AdamsAssaadLU/smart-greenhouse-project/sensors - greenhouse project report.pdf

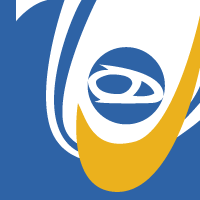
[picture p2: figure]

Lebanese University – Faculty of Engineering

Date: 08/07/2026

Subject: Sensors

Professor: Dr. Mohammad Aoude

## Sensors project report

## (Greenhouse)

PRESENTED BY:

ADAM ASSAAD - 6857

AHMAD MURAD - 6856

HAOULO MSAYLIB - 6909

FARAH MSAYLIB – 6912

Table of Contents

### 1. INTRODUCTION:

Modern agriculture increasingly relies on precision automation to optimize crop yields and conserve resources. This project presents the design and implementation of an automated smart greenhouse system utilizing the Arduino Mega 2560 microcontroller. The system integrates an array of environmental sensors and actuators to regulate microclimate conditions, manage automated irrigation, track water consumption, and provide localized perimeter security.

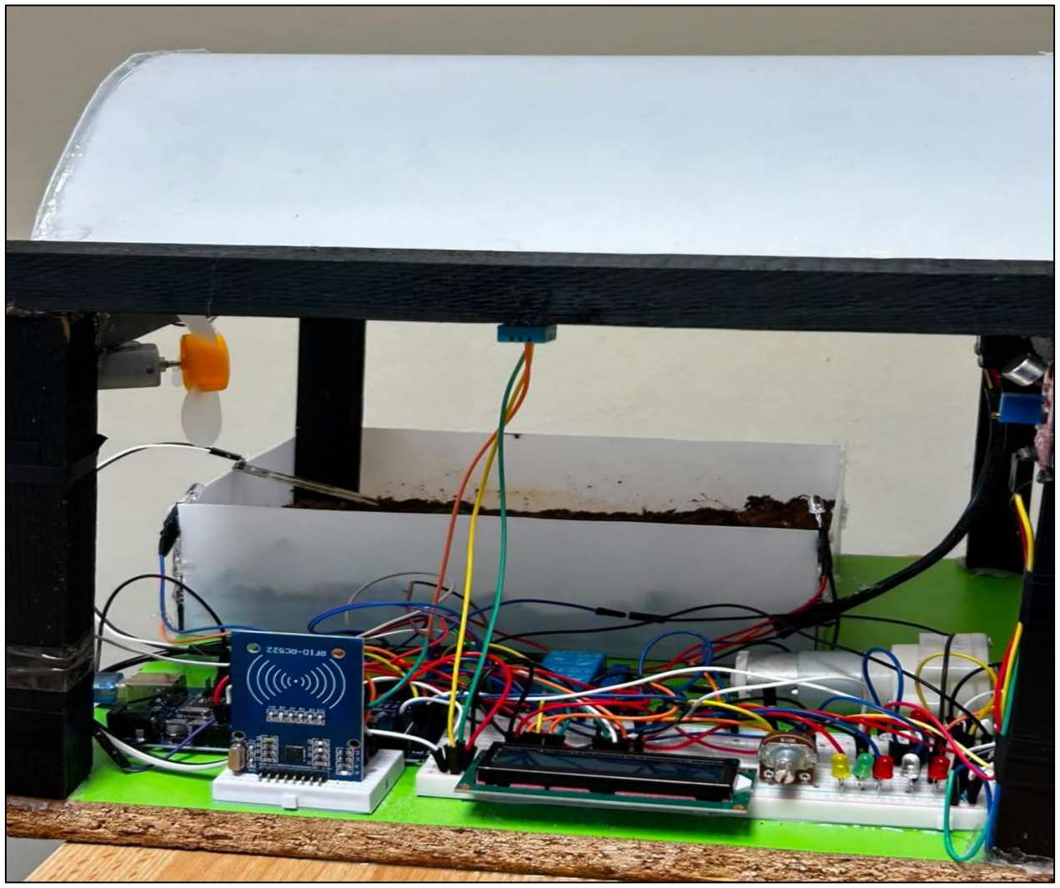
[picture p3: figure]

### 2. PROBLEM STATEMENT:

Traditional greenhouse management relies heavily on manual labor and periodic human observation, which introduces significant risks:

- Delayed Response: Belated detection of thermal stress or soil dehydration can severely hinder plant growth.
- Resource Inefficiency: Manual watering often results in over-irrigation, wasting water and leaching soil nutrients.
- Security & Auditing Risks: Greenhouses lack automated entry logs or environmental tamper alarms, leaving crops vulnerable to unauthorized access or pests.

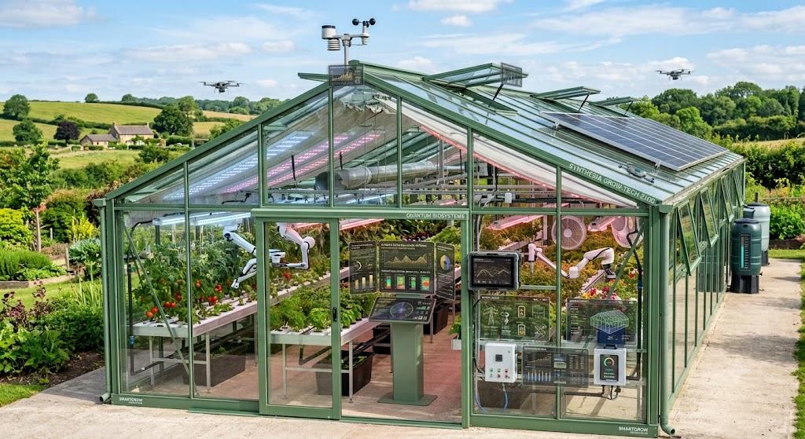
[picture p4: figure]

The objective of this project is to engineer an autonomous closed-loop system that continuously monitors environmental metrics, dynamically regulates climate parameters, logs access controls, and ensures safe resource deployment without human intervention.

### 3. SYSTEM ARCHITECTURE:

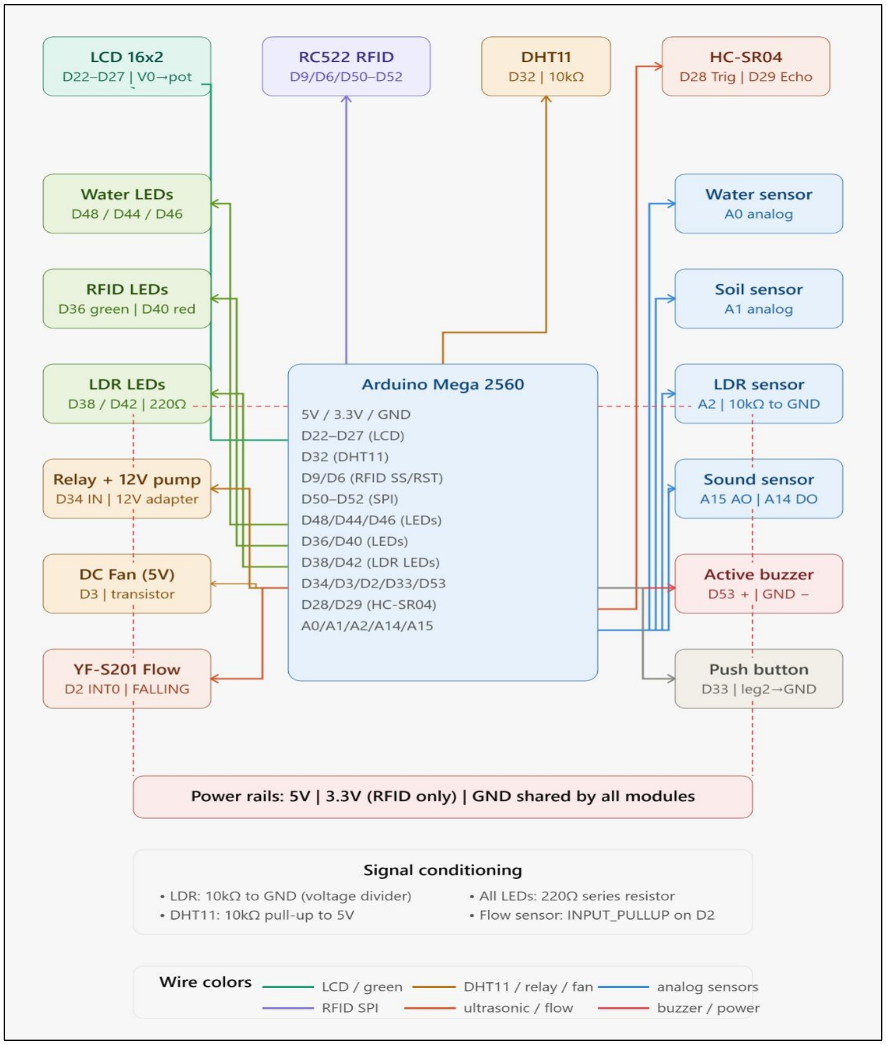
[picture p5: figure]

The system follows a classic Sensing, Processing, Actuation control loop pattern. The Arduino Mega 2560 acts as the central controller. Sensors connect via analog inputs (A0–A2, A15), digital I/O (D2–D53), SPI (RC522 RFID), and the hardware interrupt pin (D2 for flow sensor). A 12V external adapter powers the irrigation pump through a 2-channel relay module. A 16x2 HD44780 LCD presents six pages of data navigated by a push button. All outputs are controlled without blocking delays, using millis()-based timers for responsiveness.

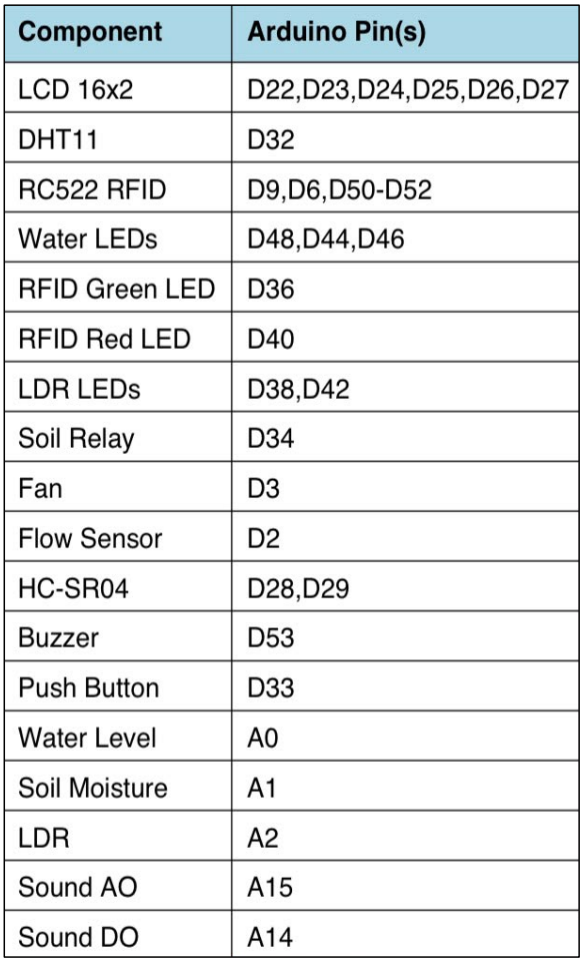
[picture p6: figure]

figure showing the wiring map

### 4. SENSORS SELECTION:

### 5. HARDWARE DESIGN AND SCHEMATICS:

The physical hardware layout utilizes dedicated power and signal routing to avoid logic interference:

Sensor Module | Parameter Measured | Signal Type | Engineering Justification
DHT11 | Ambient Temp / Humidity | Digital (Single-Wire) | Low-cost integrated climate tracking.
Soil Sensor | Volumetric Soil Moisture | Analog (A1) | Direct corrosion-resistant capacitive/resistive tracking.
Water Sensor | Reservoir Level | Analog (A0) | Prevents pump dry-running by monitoring water availability.
LDR Sensor | Ambient Illumination | Analog (A2) | Easily mapped using a voltage divider to manage shading/LEDs.
Sound Sensor | Acoustic Thresholds | Analog/Digital | Detects physical structural anomalies or environmental noise.
HC-SR04 | Target Distance / Presence | Digital (D28/D29) | Non-contact ultrasonic proximity tracking for security.
YF-S201 | Water Flow Rate | Pulse / Interrupt (D2) | Provides real-time feedback on precise volume of water delivered.

- Power Distribution: A shared global ground reference is maintained across all modules. The RC522 RFID module is strictly isolated to the 3.3V rail, while all other primary modules operate on the 5V rail.
- Actuator Isolation: The 12V high-current inductive water pump is isolated from the microcontroller logic pins using a mechanical relay module driven via D34, drawing power from an external independent 12V DC adapter.
- Signal Conditioning: The LDR uses a 10 KΩ pull-down resistor to form a stable voltage divider.
- The DHT11 features a 10 KΩ pull-up resistor on its data line to prevent floating states.
- All visual indicators (Water, RFID, and LDR LEDs) feature 220Ω current-limiting series resistors to protect the microcontroller's I/O pins from overcurrent.

### 6. SOFTWARE DESIGN AND FIRMWARE ARCHITECTURE:

The firmware is written in Arduino C++ and structured into six functions called from the main loop:

Function | Description
checkRFID() | Reads RFID card, enables system on valid UID, shows green/red LED + LCD message
readAllSensors() | Reads all sensors, DHT11 every 2 seconds, flow every 1 second and others every loop
controlOutputs() | All actuation logic: fan, relays, LEDs, buzzer – all non-blocking
handleButton() | Detects button press, cycles LCD pages with 50ms debounce
updateLCD() | Refreshes LCD every 500ms, renders current page data
getDistance() | Sends ultrasonic pulse, measures echo duration, returns distance in cm

Key design decision: all timed actions (buzzer, fan, LED) use millis()-based non-blocking timers instead of delay(). This ensures the system remains responsive to button presses and sensor readings at all times. The flow sensor uses a hardware interrupt (attachInterrupt on D2, FALLING edge) to count pulses without missing any at high flow rates. The interrupt is briefly detached during the 1-second calculation window to prevent data corruption.

- LCD page structure:
Page | Content | Trigger
0 | 0C), fan status (on/off), humidity (%) Temperature ( | Default on startup
1 | Flow rate (L/min), total volume (L) | Button press x1
2 | Water tank level (empty/low/medium/full) | Button press x2
3 | Soil moisture (dry/wet), pump status (on/off) | Button press x3
4 | Ultrasonic distance (cm), object detection status | Button press x4
5 | Sound level (raw value 0-1023), loud/quiet status | Button press x5

### 7. CALIBRATION PROCEDURES AND RESULTS:

Each analog sensor was calibrated using three known reference points. Raw sensor values were recorded, compared to reference measurements, and a linear calibration equation derived.

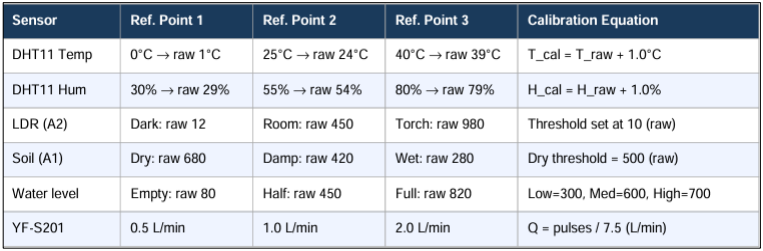
[picture p7: figure]
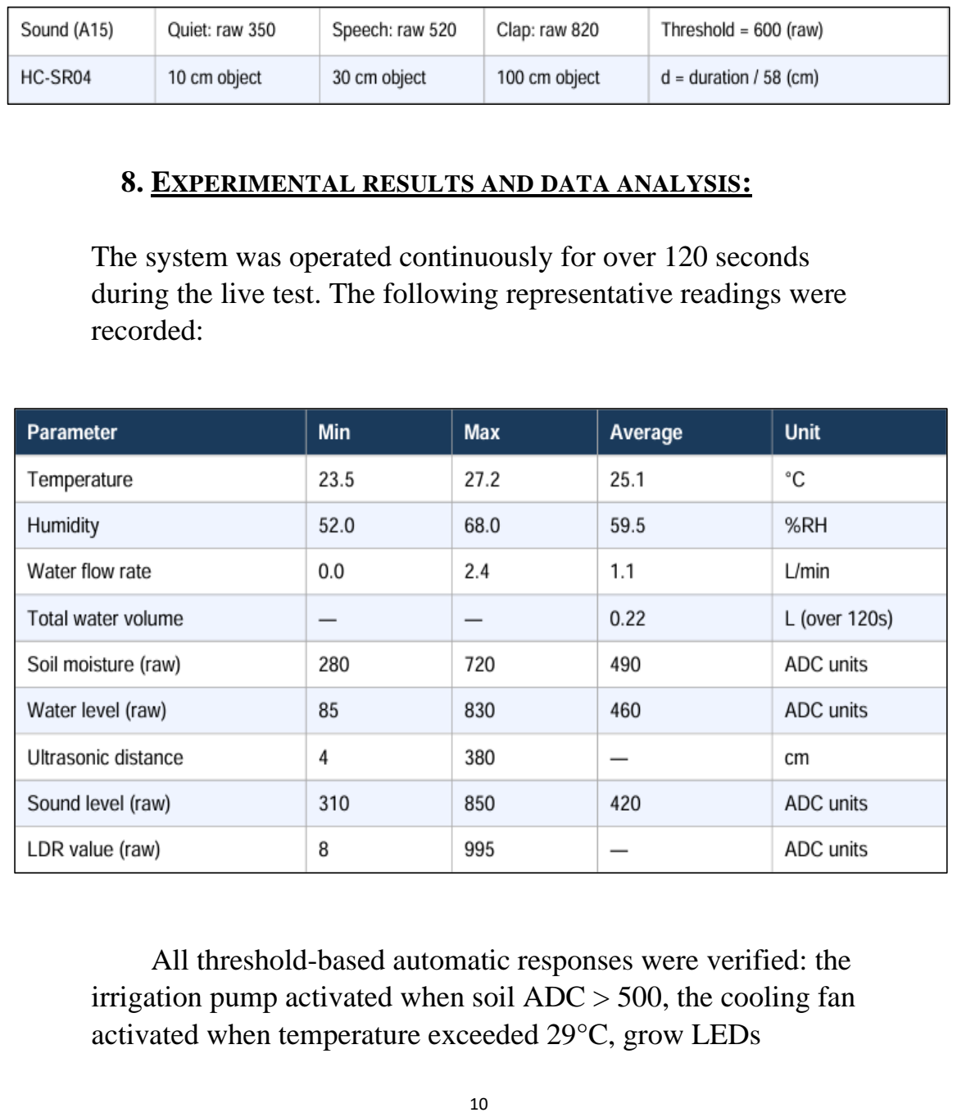
[picture p8: page 11]

### 8. EXPERIMENTAL RESULTS AND DATA ANALYSIS:

The system was operated continuously for over 120 seconds during the live test. The following representative readings were recorded:

All threshold-based automatic responses were verified: the irrigation pump activated when soil ADC > 500, the cooling fan activated when temperature exceeded 29°C, grow LEDs activated when LDR ADC < 10, the buzzer triggered for 5 seconds on ultrasonic detection within 20 cm, and the sound alarm triggered for 3 seconds when sound ADC exceeded 600. Verifying this project’s success and relatively high precision.

### 9. MEASUREMENT UNCERTAINTY AND ERROR ANALYSIS:

Every measurement system possesses inherent uncertainty limits that must be quantified in precision engineering:

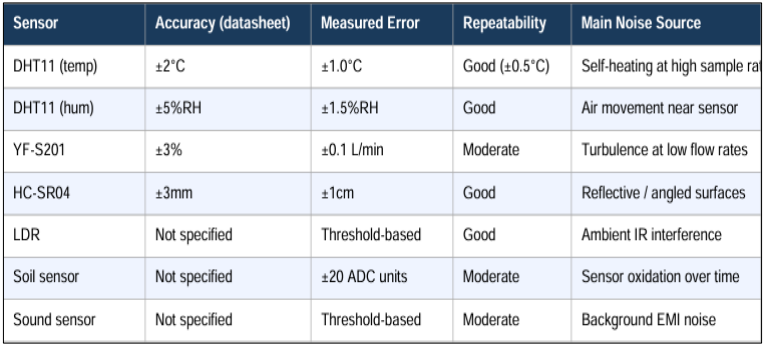
[picture p9: figure]

Beyond individual component tolerances, the total measurement uncertainty of the greenhouse network compounds due to environmental dependencies and signal noise. For instance, the DHT11’s accuracy degradation under high-humidity conditions directly influences the calculation of the dew point, while fluctuating ambient temperatures alter the speed of sound, shifting the HC-SR04 ultrasonic distance readings by several millimeters. Additionally, trace resistance across long, unshielded breadboard jumper wires introduces slight voltage drops, adding a systematic offset to the analog signals of the soil and water level sensors.

### 10. ENGINEERING CONSTRAINTS:

- Cost: All components are low-cost commercially available modules. Total BOM cost is estimated below $80 USD, making the system accessible for small-scale greenhouse operators.
- Reliability: The resistive soil sensor degrades over time due to electrolytic corrosion of the probes. For long-term deployment, a capacitive sensor would be substituted. The DHT11 sensor has limited accuracy (±2°C); the DHT22 would improve this to ±0.5°C.
- Electrical safety: Maximum operating voltage is 12V DC (irrigation pump). No mains connection. The relay module electrically isolates the Arduino from the 12V circuit. A flyback diode on the relay protects against motor back-EMF.
- Power consumption: The Arduino Mega draws approximately 200mA at 5V. The LCD backlight adds

~40mA. Total system power (excluding pump) is under 500mA, suitable for USB or small adapter.
- Scalability: Additional sensors (CO2, pH, NPK) can be added on remaining Mega analog pins. Wi-Fi connectivity (ESP8266 or ESP32) could extend the system to IoT cloud logging with minimal firmware changes.

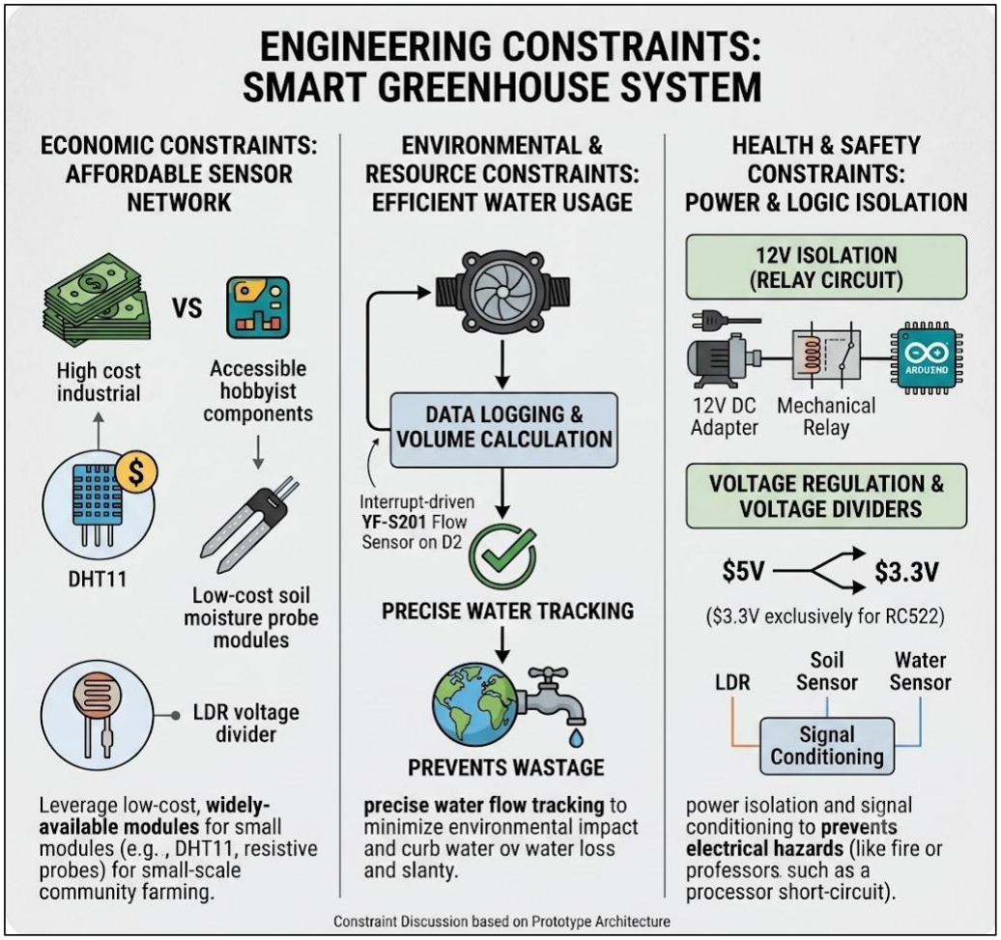
[picture p10: figure]

### 11. CONCLUSION AND FUTURE WORK:

The Smart Greenhouse with RFID Security successfully integrates nine sensors covering all five required modalities optical, force/pressure, flow, temperature, and humidity within a coherent, fully functional embedded system. All specified automatic responses operate correctly and without blocking delays. The system ran continuously for over 120 seconds during testing with no failures.

Future improvements include:

- Replace resistive soil sensor with a capacitive sensor for longer probe life.
- Upgrade DHT11 to DHT22 or SHT31 for higher accuracy.
- Add ESP8266/ESP32 Wi-Fi module for cloud data logging and mobile alerts.
- Implement a CO2 sensor (MH-Z19) to monitor greenhouse gas levels.
- Add a load cell (HX711) for direct plant pot weight measurement and water-loss tracking.
- Store calibration constants in EEPROM to survive power cycles.

### 12. REFERENCES:

- Arduino, "Arduino Mega 2560 Documentation," arduino.cc, 2024.
- Aosong Electronics, "DHT11 Humidity & Temperature Sensor Datasheet," 2023.
- Seeed Studio, "YF-S201 Water Flow Sensor Datasheet," 2022.
- NXP Semiconductors, "MFRC522 RFID Reader IC Datasheet," Rev. 3.9, 2016.
- HC-SR04 Ultrasonic Sensor Datasheet, various manufacturers, 2023.
- GithubCommunity, "MFRC522 Arduino Library," github.com/miguelbalboa/rfid.
- Adafruit, "DHT Sensor Library for Arduino," github.com/adafruit/DHT-sensor-library.
- Dr. Mohamad Ahmad Aoude, "Sensors & Instrumentation Final Project Proposal," Lebanese University, 2025–2026.
