AdamsAssaadLU/smart-greenhouse-project/Adam Assad 6857.pdf

Lebanese University – Faculty of Engineering Subject: Sensors
Professor: Dr. Mohammad Aoude

### Presented by: Adam Assaad - 6857

## Sensors project

## (Greenhousse)

### 1. Summary of Contribution

I was responsible for the physical hardware layer of the greenhouse: wiring every sensor and actuator to the Arduino Mega 2560, planning the power distribuon between the 5V and 3.3V rails, and building the signalcondioning circuits (the LDR voltage divider, the DHT11 pull-up, and the 220W current-liming resistors on all indicator LEDs). I also handled the electrical isolaon of the 12V irrigaon pump through the 2-channel relay module and the external 12V adapter, and I assembled the wooden and acrylic enclosure that houses the breadboard, LCD, and RFID reader shown in the final prototype photo. Toward the end of the project I helped trace and fix a systemac offset on the soil and water-level analog readings that turned out to be caused by resistance in long, unshielded jumper wires, which we corrected by shortening runs and re-roung the breadboard layout

### 2. Git Activity

- Add inial wiring diagram for sensor layout
- Wire DHT11 with 10k pull-up resistor
- Wire soil moisture and water level sensors to A1/A0
- Add relay module wiring for 12V irrigaon pump
- Build enclosure mounts for LCD and RFID reader
- Fix analog offset caused by long jumper wire runs
- Add 220-ohm resistors to LED indicator circuits

### 3. Reflection

Working on the hardware side taught me how much small electrical details mater in a system this size — a single loose ground connecon or an underrated resistor could throw off readings across the whole board. Debugging the jumper-wire offset in parcular was a good lesson in tracing a sowarelooking symptom back to a physical cause. I'd like to get more comfortable with PCB design so a future version of this project could replace the breadboard with something more robust.
